esmat1103/can-analyzer-stm32/docs/demo.gif

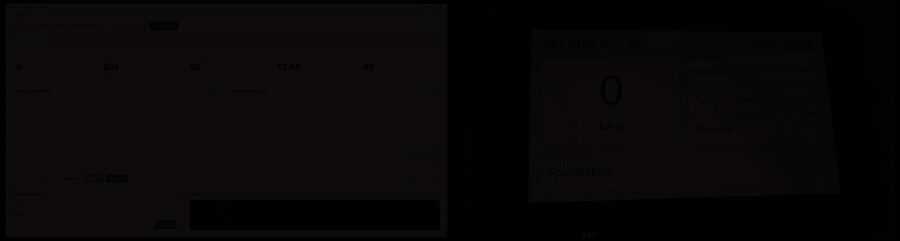
docs/demo.gif
