esmat1103/can-analyzer-stm32/docs/f7_dashboard.jpg

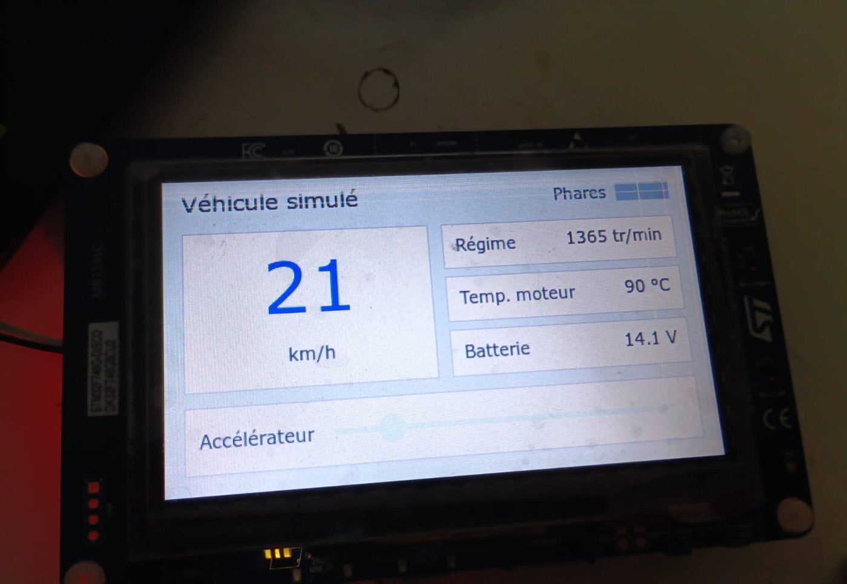
docs/f7_dashboard.jpg
