esmat1103/can-analyzer-stm32/docs/qt_dashboard.png

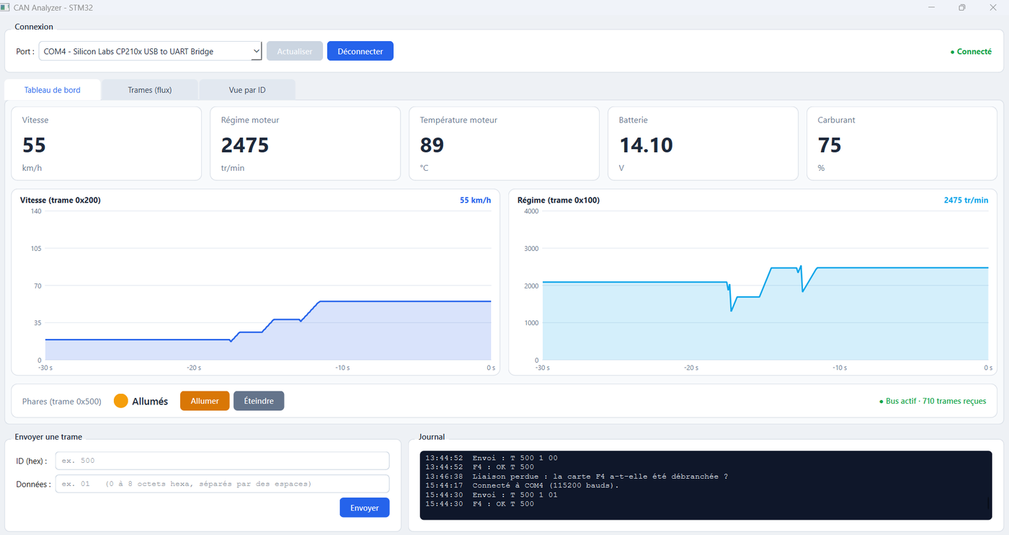
docs/qt_dashboard.png
