esmat1103/can-analyzer-stm32/docs/qt_flux.png

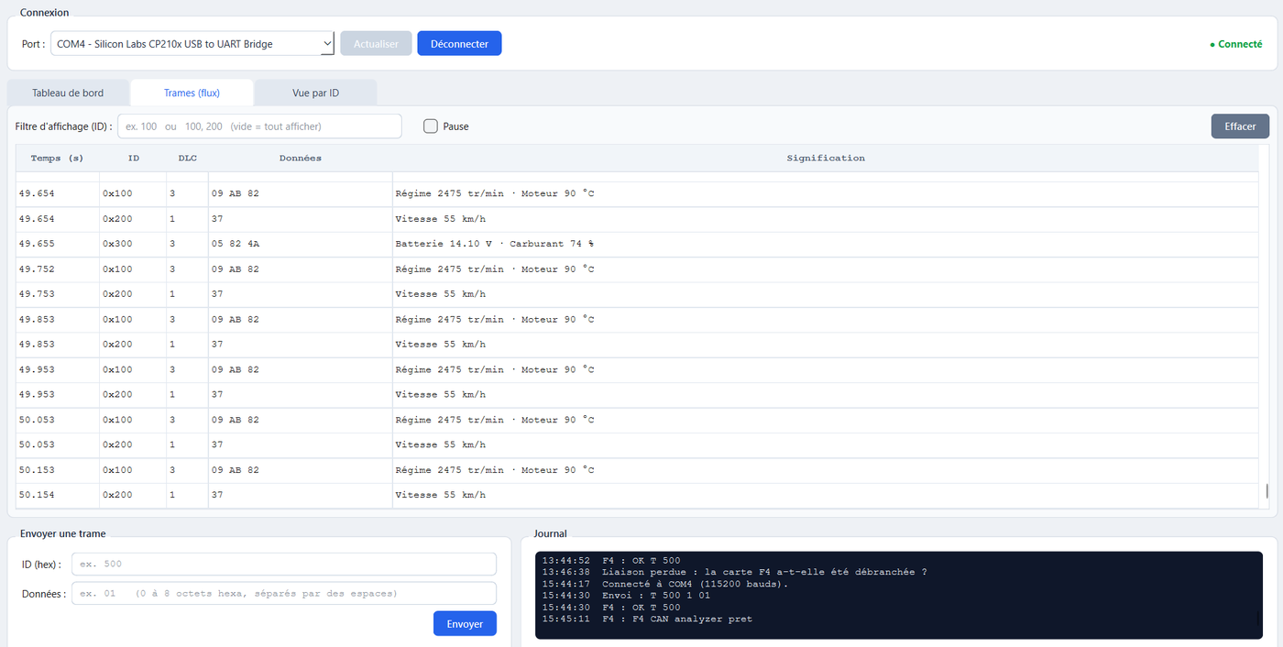
docs/qt_flux.png
