esmat1103/can-analyzer-stm32/docs/qt_par_id.png

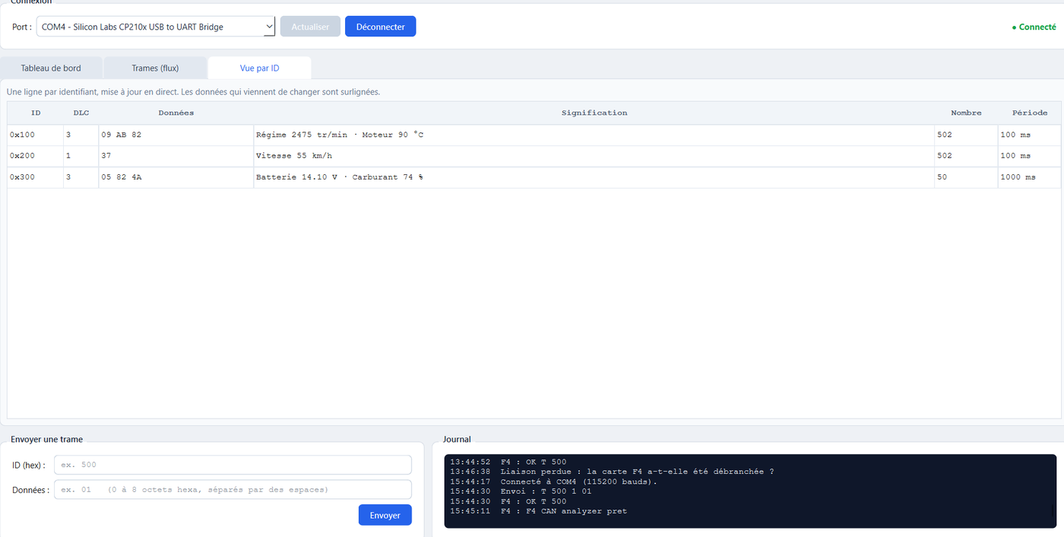
docs/qt_par_id.png
