esmat1103/can-analyzer-stm32/docs/montage.jpg

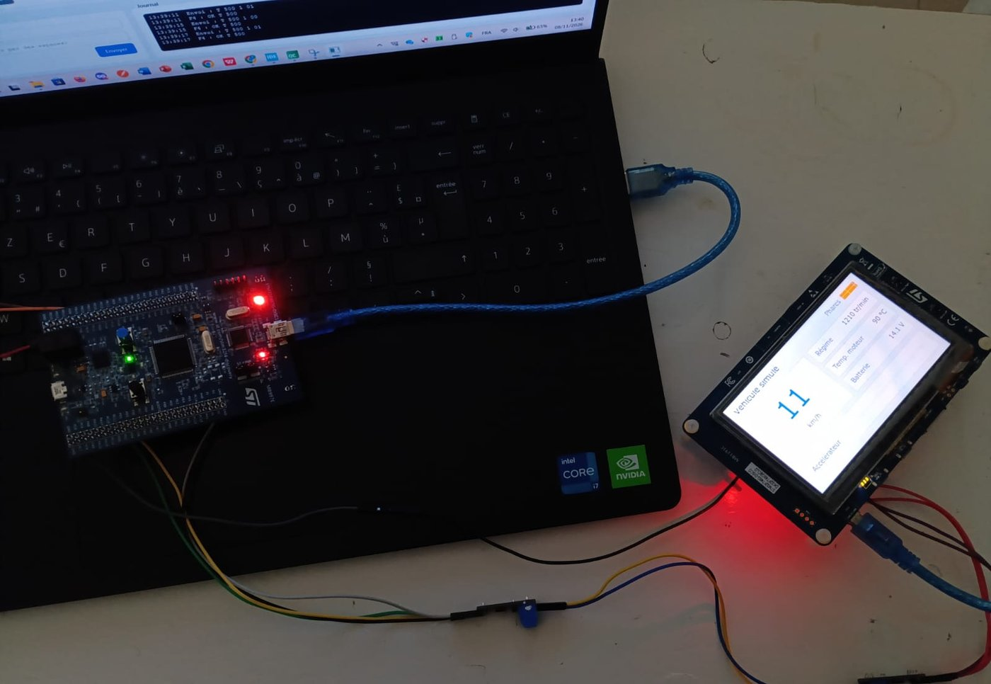
docs/montage.jpg
