esmat1103/can-analyzer-stm32/firmware/F7_vehicle_touchgfx/Core/Src/main.c

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
/* Includes ------------------------------------------------------------------*/
#include "main.h"
#include "cmsis_os.h"
#include "libjpeg.h"
#include "app_touchgfx.h"

/* USER CODE BEGIN Includes */
#include "gui/vehicule.h"
/* USER CODE END Includes */

/* USER CODE BEGIN PD */

#define REFRESH_COUNT        1835

#define SDRAM_TIMEOUT                            ((uint32_t)0xFFFF)
#define SDRAM_MODEREG_BURST_LENGTH_1             ((uint16_t)0x0000)
#define SDRAM_MODEREG_BURST_LENGTH_2             ((uint16_t)0x0001)
#define SDRAM_MODEREG_BURST_LENGTH_4             ((uint16_t)0x0002)
#define SDRAM_MODEREG_BURST_LENGTH_8             ((uint16_t)0x0004)
#define SDRAM_MODEREG_BURST_TYPE_SEQUENTIAL      ((uint16_t)0x0000)
#define SDRAM_MODEREG_BURST_TYPE_INTERLEAVED     ((uint16_t)0x0008)
#define SDRAM_MODEREG_CAS_LATENCY_2              ((uint16_t)0x0020)
#define SDRAM_MODEREG_CAS_LATENCY_3              ((uint16_t)0x0030)
#define SDRAM_MODEREG_OPERATING_MODE_STANDARD    ((uint16_t)0x0000)
#define SDRAM_MODEREG_WRITEBURST_MODE_PROGRAMMED ((uint16_t)0x0000)
#define SDRAM_MODEREG_WRITEBURST_MODE_SINGLE     ((uint16_t)0x0200)

#define FLASH_READ_JEDEC_ID				0x9F
#define FLASH_FAST_READ_QUAD_IO		 	0xEB
#define FLASH_REVC03_MANUFACTURER_ID	0xEF
#define FLASH_N25Q128A_DUMMY_CYCLES		0x0A
#define FLASH_W25Q128J_DUMMY_CYCLES		0x06

/* USER CODE END PD */

CAN_HandleTypeDef hcan1;

CRC_HandleTypeDef hcrc;

DMA2D_HandleTypeDef hdma2d;

I2C_HandleTypeDef hi2c3;

LTDC_HandleTypeDef hltdc;

QSPI_HandleTypeDef hqspi;

SDRAM_HandleTypeDef hsdram1;

/* Definitions for defaultTask */
osThreadId_t defaultTaskHandle;
const osThreadAttr_t defaultTask_attributes = {
  .name = "defaultTask",
  .stack_size = 256 * 4,
  .priority = (osPriority_t) osPriorityNormal,
};
/* Definitions for TouchGFXTask */
osThreadId_t TouchGFXTaskHandle;
const osThreadAttr_t TouchGFXTask_attributes = {
  .name = "TouchGFXTask",
  .stack_size = 4096 * 4,
  .priority = (osPriority_t) osPriorityNormal,
};
/* Definitions for videoTask */
osThreadId_t videoTaskHandle;
const osThreadAttr_t videoTask_attributes = {
  .name = "videoTask",
  .stack_size = 1000 * 4,
  .priority = (osPriority_t) osPriorityLow,
};
/* Definitions for vehiculeTas */
osThreadId_t vehiculeTasHandle;
const osThreadAttr_t vehiculeTas_attributes = {
  .name = "vehiculeTas",
  .stack_size = 256 * 4,
  .priority = (osPriority_t) osPriorityNormal,
};
/* USER CODE BEGIN PV */
static FMC_SDRAM_CommandTypeDef Command;

/* Etat partage du vehicule : ecrit par la tache vehicule et l'interruption CAN, lu par l'ecran */
static volatile EtatVehicule etat = {0, 800, 20, 126, 0};
static volatile int consigneVitesse = 0;   /* valeur du curseur, en km/h */
/* USER CODE END PV */

void SystemClock_Config(void);
static void MPU_Config(void);
static void MX_GPIO_Init(void);
static void MX_CRC_Init(void);
static void MX_DMA2D_Init(void);
static void MX_FMC_Init(void);
static void MX_I2C3_Init(void);
static void MX_LTDC_Init(void);
static void MX_QUADSPI_Init(void);
static void MX_CAN1_Init(void);
void StartDefaultTask(void *argument);
extern void TouchGFX_Task(void *argument);
extern void videoTaskFunc(void *argument);
void StartVehiculeTask(void *argument);

/* USER CODE BEGIN PFP */
void GetManufacturerId (uint8_t *manufacturer_id);
void EnableMemoryMappedMode(uint8_t manufacturer_id);  

/* USER CODE END PFP */

/* USER CODE BEGIN 0 */
/* ---------- Fonctions appelees par l'ecran ---------- */

void Vehicule_SetConsigne(int vitesse_kmh)
{
  if (vitesse_kmh < 0)   vitesse_kmh = 0;
  if (vitesse_kmh > 130) vitesse_kmh = 130;
  consigneVitesse = vitesse_kmh;
}

void Vehicule_LireEtat(EtatVehicule *e)
{
  /* Copie protegee : personne ne peut modifier l'etat pendant la lecture */
  uint32_t primask = __get_PRIMASK();
  __disable_irq();
  e->vitesse     = etat.vitesse;
  e->regime      = etat.regime;
  e->temperature = etat.temperature;
  e->tension_dV  = etat.tension_dV;
  e->phares      = etat.phares;
  __set_PRIMASK(primask);
}

/* ---------- Envoi d'une trame CAN standard ---------- */

static void envoyerTrame(uint32_t id, uint8_t *data, uint8_t dlc)
{
  CAN_TxHeaderTypeDef entete = {0};
  uint32_t boite;

  entete.StdId = id;
  entete.IDE   = CAN_ID_STD;
  entete.RTR   = CAN_RTR_DATA;
  entete.DLC   = dlc;

  /* Si les 3 boites d'envoi sont pleines (personne sur le bus), on saute */
  if (HAL_CAN_GetTxMailboxesFreeLevel(&hcan1) > 0)
  {
    HAL_CAN_AddTxMessage(&hcan1, &entete, data, &boite);
  }
}

/* ---------- Reception : appelee par l'interruption CAN ---------- */

void HAL_CAN_RxFifo0MsgPendingCallback(CAN_HandleTypeDef *hcan)
{
  CAN_RxHeaderTypeDef entete;
  uint8_t data[8];

  while (HAL_CAN_GetRxFifoFillLevel(hcan, CAN_RX_FIFO0) > 0)
  {
    if (HAL_CAN_GetRxMessage(hcan, CAN_RX_FIFO0, &entete, data) != HAL_OK)
      break;

    /* Trame 0x500 = commande des phares (octet 0 : 01 allume, 00 eteint) */
    if (entete.IDE == CAN_ID_STD && entete.StdId == 0x500 && entete.DLC >= 1)
    {
      etat.phares = (data[0] != 0) ? 1 : 0;
    }
  }
}

/* ---------- Simulation du vehicule (tache FreeRTOS, toutes les 100 ms) ---------- */

void Vehicule_Tache(void)
{
  /* Rapport tr/min par km/h pour chaque vitesse de boite (index 1 a 5) */
  static const float rapport[6] = {0.0f, 110.0f, 65.0f, 45.0f, 35.0f, 28.0f};

  float vitesse     = 0.0f;
  float temperature = 20.0f;
  int carburant     = 75;          /* en % */
  uint32_t compteur = 0;
  uint32_t prochain = osKernelGetTickCount();
  uint8_t d[8];

  for (;;)
  {
    prochain += 100;               /* prochaine execution dans 100 ms */

    /* 1. La vitesse rejoint progressivement la consigne du curseur */
    int cible = consigneVitesse;
    if (vitesse < cible)
    {
      vitesse += 1.5f;
      if (vitesse > cible) vitesse = (float)cible;
    }
    else if (vitesse > cible)
    {
      vitesse -= 2.0f;
      if (vitesse < cible) vitesse = (float)cible;
    }
    int v = (int)(vitesse + 0.5f);

    /* 2. Le regime depend de la vitesse et du rapport engage */
    int rapportEngage = (v < 20) ? 1 : (v < 40) ? 2 : (v < 60) ? 3 : (v < 85) ? 4 : 5;
    int regime = (int)(vitesse * rapport[rapportEngage]);
    if (regime < 800) regime = 800;

    /* 3. Le moteur chauffe doucement jusqu'a 90 degres */
    temperature += (90.0f - temperature) * 0.01f;
    int temp = (int)(temperature + 0.5f);

    /* 4. Batterie : 14.1 V quand l'alternateur charge, 12.6 V au ralenti */
    int tension = (regime > 900) ? 141 : 126;

    /* 5. Carburant : -1 % par minute */
    if ((compteur % 600) == 599 && carburant > 5) carburant--;

    /* Mise a jour de l'etat lu par l'ecran */
    etat.vitesse     = v;
    etat.regime      = regime;
    etat.temperature = temp;
    etat.tension_dV  = tension;

    /* Trame 0x100 (moteur, 100 ms) : regime sur 2 octets + temperature + 40 */
    d[0] = (uint8_t)(regime >> 8);
    d[1] = (uint8_t)(regime & 0xFF);
    d[2] = (uint8_t)(temp + 40);
    envoyerTrame(0x100, d, 3);

    /* Trame 0x200 (ABS, 100 ms) : vitesse en km/h */
    d[0] = (uint8_t)v;
    envoyerTrame(0x200, d, 1);

    /* Trame 0x300 (batterie, 1 s) : tension en centiemes de volt + carburant */
    if ((compteur % 10) == 0)
    {
      int centiemes = tension * 10;
      d[0] = (uint8_t)(centiemes >> 8);
      d[1] = (uint8_t)(centiemes & 0xFF);
      d[2] = (uint8_t)carburant;
      envoyerTrame(0x300, d, 3);
    }

    compteur++;
    osDelayUntil(prochain);
  }
}


/* USER CODE END 0 */

/**
  * @brief  The application entry point.
  * @retval int
  */
int main(void)
{

  /* MPU Configuration--------------------------------------------------------*/
  MPU_Config();

  /* Enable the CPU Cache */

  /* Enable I-Cache---------------------------------------------------------*/
  SCB_EnableICache();

  /* Enable D-Cache---------------------------------------------------------*/
  SCB_EnableDCache();

  /* MCU Configuration--------------------------------------------------------*/

  /* Reset of all peripherals, Initializes the Flash interface and the Systick. */
  HAL_Init();

  /* Configure the system clock */
  SystemClock_Config();

  /* Initialize all configured peripherals */
  MX_GPIO_Init();
  MX_CRC_Init();
  MX_DMA2D_Init();
  MX_FMC_Init();
  MX_I2C3_Init();
  MX_LTDC_Init();
  MX_QUADSPI_Init();
  MX_LIBJPEG_Init();
  MX_CAN1_Init();
  MX_TouchGFX_Init();
  /* Call PreOsInit function */
  MX_TouchGFX_PreOSInit();
  /* USER CODE BEGIN 2 */
  /* Filtre CAN : on ne recoit QUE la trame 0x500 (commande des phares) */
    CAN_FilterTypeDef filtre = {0};
    filtre.FilterBank           = 0;
    filtre.FilterMode           = CAN_FILTERMODE_IDMASK;
    filtre.FilterScale          = CAN_FILTERSCALE_32BIT;
    filtre.FilterIdHigh         = 0x500 << 5;
    filtre.FilterIdLow          = 0x0000;
    filtre.FilterMaskIdHigh     = 0x7FF << 5;
    filtre.FilterMaskIdLow      = 0x0000;
    filtre.FilterFIFOAssignment = CAN_RX_FIFO0;
    filtre.FilterActivation     = ENABLE;
    filtre.SlaveStartFilterBank = 14;
    if (HAL_CAN_ConfigFilter(&hcan1, &filtre) != HAL_OK) Error_Handler();

    if (HAL_CAN_ActivateNotification(&hcan1, CAN_IT_RX_FIFO0_MSG_PENDING) != HAL_OK) Error_Handler();
    if (HAL_CAN_Start(&hcan1) != HAL_OK) Error_Handler();
  /* USER CODE END 2 */

  /* Init scheduler */
  osKernelInitialize();

  /* USER CODE BEGIN RTOS_MUTEX */
  /* add mutexes, ... */
  /* USER CODE END RTOS_MUTEX */

  /* USER CODE BEGIN RTOS_SEMAPHORES */
  /* add semaphores, ... */
  /* USER CODE END RTOS_SEMAPHORES */

  /* USER CODE BEGIN RTOS_TIMERS */
  /* start timers, add new ones, ... */
  /* USER CODE END RTOS_TIMERS */

  /* USER CODE BEGIN RTOS_QUEUES */
  /* add queues, ... */
  /* USER CODE END RTOS_QUEUES */

  /* Create the thread(s) */
  /* creation of defaultTask */
  defaultTaskHandle = osThreadNew(StartDefaultTask, NULL, &defaultTask_attributes);

  /* creation of TouchGFXTask */
  TouchGFXTaskHandle = osThreadNew(TouchGFX_Task, NULL, &TouchGFXTask_attributes);

  /* creation of videoTask */
  videoTaskHandle = osThreadNew(videoTaskFunc, NULL, &videoTask_attributes);

  /* creation of vehiculeTas */
  vehiculeTasHandle = osThreadNew(StartVehiculeTask, NULL, &vehiculeTas_attributes);

  /* USER CODE BEGIN RTOS_THREADS */
  /* add threads, ... */
  /* USER CODE END RTOS_THREADS */

  /* USER CODE BEGIN RTOS_EVENTS */
  /* add events, ... */
  /* USER CODE END RTOS_EVENTS */

  /* Start scheduler */
  osKernelStart();

  /* We should never get here as control is now taken by the scheduler */

  /* Infinite loop */
  /* USER CODE BEGIN WHILE */
  while (1)
  {
    /* USER CODE END WHILE */

    /* USER CODE BEGIN 3 */
  }
  /* USER CODE END 3 */
}

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
/* USER CODE BEGIN 4 */

// Read manufacturer ID of external QSPI flash
void GetManufacturerId (uint8_t *manufacturer_id)
{
  QSPI_CommandTypeDef s_command_id;

  /* Initialize the read flag status register command */
  s_command_id.InstructionMode   = QSPI_INSTRUCTION_1_LINE;
  s_command_id.Instruction       = FLASH_READ_JEDEC_ID;
  s_command_id.AddressMode       = QSPI_ADDRESS_NONE;
  s_command_id.AlternateByteMode = QSPI_ALTERNATE_BYTES_NONE;
  s_command_id.DataMode          = QSPI_DATA_1_LINE;
  s_command_id.DummyCycles       = 0;
  s_command_id.NbData            = 1;
  s_command_id.DdrMode           = QSPI_DDR_MODE_DISABLE;
  s_command_id.DdrHoldHalfCycle  = QSPI_DDR_HHC_ANALOG_DELAY;
  s_command_id.SIOOMode          = QSPI_SIOO_INST_EVERY_CMD;

  /* Configure the command */
  if (HAL_QSPI_Command(&hqspi, &s_command_id, HAL_QPSI_TIMEOUT_DEFAULT_VALUE) != HAL_OK)
  {
	  Error_Handler();
  }

  /* Reception of the data */
  if (HAL_QSPI_Receive(&hqspi, manufacturer_id, HAL_QPSI_TIMEOUT_DEFAULT_VALUE) != HAL_OK)
  {
	  Error_Handler();
  }
}

// Enable memory mapped mode for external QSPI flash
void EnableMemoryMappedMode(uint8_t manufacturer_id)  
{
  QSPI_CommandTypeDef      s_command;
  QSPI_MemoryMappedTypeDef s_mem_mapped_cfg;

  /* Configure the command for the read instruction */
  s_command.InstructionMode   = QSPI_INSTRUCTION_1_LINE;
  s_command.Instruction       = FLASH_FAST_READ_QUAD_IO;
  s_command.AddressMode       = QSPI_ADDRESS_4_LINES;
  s_command.AddressSize       = QSPI_ADDRESS_24_BITS;
  s_command.AlternateByteMode = QSPI_ALTERNATE_BYTES_NONE;
  s_command.DataMode          = QSPI_DATA_4_LINES;
  
  // Set dummy cycles according to manufacturer ID
  s_command.DummyCycles       = manufacturer_id == FLASH_REVC03_MANUFACTURER_ID ? FLASH_W25Q128J_DUMMY_CYCLES : FLASH_N25Q128A_DUMMY_CYCLES;

  s_command.DdrMode           = QSPI_DDR_MODE_DISABLE;
  s_command.DdrHoldHalfCycle  = QSPI_DDR_HHC_ANALOG_DELAY;
  s_command.SIOOMode          = QSPI_SIOO_INST_EVERY_CMD;
  
  /* Configure the memory mapped mode */
  s_mem_mapped_cfg.TimeOutActivation = QSPI_TIMEOUT_COUNTER_DISABLE;
  s_mem_mapped_cfg.TimeOutPeriod     = 0;
  
  if (HAL_QSPI_MemoryMapped(&hqspi, &s_command, &s_mem_mapped_cfg) != HAL_OK)
  {
    Error_Handler();
  }
}

/* USER CODE END 4 */

/* USER CODE BEGIN Header_StartDefaultTask */
/**
  * @brief  Function implementing the defaultTask thread.
  * @param  argument: Not used
  * @retval None
  */
/* USER CODE END Header_StartDefaultTask */
void StartDefaultTask(void *argument)
{
  /* USER CODE BEGIN 5 */
  /* Infinite loop */
  for(;;)
  {
    osDelay(100);
  }
  /* USER CODE END 5 */
}

/* USER CODE BEGIN Header_StartVehiculeTask */
/**
* @brief Function implementing the vehiculeTas thread.
* @param argument: Not used
* @retval None
*/
/* USER CODE END Header_StartVehiculeTask */
__weak void StartVehiculeTask(void *argument)
{
  /* USER CODE BEGIN StartVehiculeTask */
  /* Infinite loop */
	  Vehicule_Tache();

  /* USER CODE END StartVehiculeTask */
}

 /* MPU Configuration */

void MPU_Config(void)
{
  MPU_Region_InitTypeDef MPU_InitStruct = {0};

  /* Disables the MPU */
  HAL_MPU_Disable();

  /** Initializes and configures the Region and the memory to be protected
  */
  MPU_InitStruct.Enable = MPU_REGION_ENABLE;
  MPU_InitStruct.Number = MPU_REGION_NUMBER0;
  MPU_InitStruct.BaseAddress = 0x90000000;
  MPU_InitStruct.Size = MPU_REGION_SIZE_256MB;
  MPU_InitStruct.SubRegionDisable = 0x0;
  MPU_InitStruct.TypeExtField = MPU_TEX_LEVEL0;
  MPU_InitStruct.AccessPermission = MPU_REGION_FULL_ACCESS;
  MPU_InitStruct.DisableExec = MPU_INSTRUCTION_ACCESS_ENABLE;
  MPU_InitStruct.IsShareable = MPU_ACCESS_NOT_SHAREABLE;
  MPU_InitStruct.IsCacheable = MPU_ACCESS_NOT_CACHEABLE;
  MPU_InitStruct.IsBufferable = MPU_ACCESS_NOT_BUFFERABLE;

  HAL_MPU_ConfigRegion(&MPU_InitStruct);

  /** Initializes and configures the Region and the memory to be protected
  */
  MPU_InitStruct.Number = MPU_REGION_NUMBER1;
  MPU_InitStruct.Size = MPU_REGION_SIZE_16MB;
  MPU_InitStruct.IsCacheable = MPU_ACCESS_CACHEABLE;

  HAL_MPU_ConfigRegion(&MPU_InitStruct);
  /* Enables the MPU */
  HAL_MPU_Enable(MPU_PRIVILEGED_DEFAULT);

}

/**
  * @brief  Period elapsed callback in non blocking mode
  * @note   This function is called  when TIM6 interrupt took place, inside
  * HAL_TIM_IRQHandler(). It makes a direct call to HAL_IncTick() to increment
  * a global variable "uwTick" used as application time base.
  * @param  htim : TIM handle
  * @retval None
  */
void HAL_TIM_PeriodElapsedCallback(TIM_HandleTypeDef *htim)
{
  if (htim->Instance == TIM6)
  {
    HAL_IncTick();
  }
}

/**
  * @brief  This function is executed in case of error occurrence.
  * @retval None
  */
void Error_Handler(void)
{
  /* USER CODE BEGIN Error_Handler_Debug */
  /* User can add his own implementation to report the HAL error return state */

  /* USER CODE END Error_Handler_Debug */
}
#ifdef USE_FULL_ASSERT
/**
  * @brief  Reports the name of the source file and the source line number
  *         where the assert_param error has occurred.
  * @param  file: pointer to the source file name
  * @param  line: assert_param error line source number
  * @retval None
  */
void assert_failed(uint8_t *file, uint32_t line)
{
  /* USER CODE BEGIN 6 */
  /* User can add his own implementation to report the file name and line number,
     tex: printf("Wrong parameters value: file %s on line %d\r\n", file, line) */
  /* USER CODE END 6 */
}
#endif /* USE_FULL_ASSERT */
