esmat1103/can-analyzer-stm32/firmware/F7_vehicle_touchgfx/MyApplication.ioc

Mcu.UserName=STM32F746NGHx
PA13.Signal=SYS_JTMS-SWDIO
PA14.Signal=SYS_JTCK-SWCLK
PB2.Signal=QUADSPI_CLK
PB4.GPIO_Label=VSYNC_FREQ
PB4.Signal=GPIO_Output
PB6.Signal=QUADSPI_BK1_NCS
PB8.Signal=CAN1_RX
PB9.Signal=CAN1_TX
PC3.Signal=FMC_SDCKE0
PC6.GPIO_Label=RENDER_TIME
PC6.Signal=GPIO_Output
PC7.GPIO_Label=FRAME_RATE
PC7.Signal=GPIO_Output
PD0.Signal=FMC_D2_DA2
PD1.Signal=FMC_D3_DA3
PD10.Signal=FMC_D15_DA15
PD11.Signal=QUADSPI_BK1_IO0
PD12.Signal=QUADSPI_BK1_IO1
PD13.Signal=QUADSPI_BK1_IO3
PD14.Signal=FMC_D0_DA0
PD15.Signal=FMC_D1_DA1
PD8.Signal=FMC_D13_DA13
PD9.Signal=FMC_D14_DA14
PE0.Signal=FMC_NBL0
PE1.Signal=FMC_NBL1
PE10.Signal=FMC_D7_DA7
PE11.Signal=FMC_D8_DA8
PE12.Signal=FMC_D9_DA9
PE13.Signal=FMC_D10_DA10
PE14.Signal=FMC_D11_DA11
PE15.Signal=FMC_D12_DA12
PE2.Signal=QUADSPI_BK1_IO2
PE4.Signal=LTDC_B0
PE7.Signal=FMC_D4_DA4
PE8.Signal=FMC_D5_DA5
PE9.Signal=FMC_D6_DA6
PF0.Signal=FMC_A0
PF1.Signal=FMC_A1
PF11.Signal=FMC_SDNRAS
PF12.Signal=FMC_A6
PF13.Signal=FMC_A7
PF14.Signal=FMC_A8
PF15.Signal=FMC_A9
PF2.Signal=FMC_A2
PF3.Signal=FMC_A3
PF4.Signal=FMC_A4
PF5.Signal=FMC_A5
PG0.Signal=FMC_A10
PG1.Signal=FMC_A11
PG12.Signal=LTDC_B4
PG15.Signal=FMC_SDNCAS
PG4.Signal=FMC_A14_BA0
PG5.Signal=FMC_A15_BA1
PG6.GPIO_Label=MCU_ACTIVE
PG6.Signal=GPIO_Output
PG8.Signal=FMC_SDCLK
PH0/OSC_IN.Signal=RCC_OSC_IN
PH1/OSC_OUT.Signal=RCC_OSC_OUT
PH3.Signal=FMC_SDNE0
PH5.Signal=FMC_SDNWE
PH7.Signal=I2C3_SCL
PH8.Signal=I2C3_SDA
PI10.Signal=LTDC_HSYNC
PI12.GPIO_Label=LCD_DISP
PI12.Signal=GPIO_Output
PI14.Signal=LTDC_CLK
PI15.Signal=LTDC_R0
PI9.Signal=LTDC_VSYNC
PJ0.Signal=LTDC_R1
PJ1.Signal=LTDC_R2
PJ10.Signal=LTDC_G3
PJ11.Signal=LTDC_G4
PJ13.Signal=LTDC_B1
PJ14.Signal=LTDC_B2
PJ15.Signal=LTDC_B3
PJ2.Signal=LTDC_R3
PJ3.Signal=LTDC_R4
PJ4.Signal=LTDC_R5
PJ5.Signal=LTDC_R6
PJ6.Signal=LTDC_R7
PJ7.Signal=LTDC_G0
PJ8.Signal=LTDC_G1
PJ9.Signal=LTDC_G2
PK0.Signal=LTDC_G5
PK1.Signal=LTDC_G6
PK2.Signal=LTDC_G7
PK3.GPIO_Label=LCD_BL_CTRL
PK3.Signal=GPIO_Output
PK4.Signal=LTDC_B5
PK5.Signal=LTDC_B6
PK6.Signal=LTDC_B7
PK7.Signal=LTDC_DE
