esmat1103/can-analyzer-stm32/firmware/F4_can_gateway/Core/Src/main.c

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
/* Includes ------------------------------------------------------------------*/
#include "main.h"

/* USER CODE BEGIN Includes */
#include <stdio.h>
#include <string.h>
#include <stdlib.h>
/* USER CODE END Includes */

/* USER CODE BEGIN PTD */
typedef struct {
    uint32_t id;
    uint8_t dlc;
    uint8_t data[8];
} TrameCAN;
/* USER CODE END PTD */

/* USER CODE BEGIN PD */
#define TAILLE_FILE 32
#define TAILLE_LIGNE 64
/* USER CODE END PD */

CAN_HandleTypeDef hcan1;

UART_HandleTypeDef huart2;

/* USER CODE BEGIN PV */
volatile TrameCAN file[TAILLE_FILE];
volatile uint8_t tete = 0;
volatile uint8_t queue = 0;
volatile uint32_t trames_perdues = 0;

uint8_t octet_recu;
char ligne_pc[TAILLE_LIGNE];
volatile uint8_t pos_ligne = 0;
volatile uint8_t ligne_prete = 0;

/* USER CODE END PV */

void SystemClock_Config(void);
static void MX_GPIO_Init(void);
static void MX_CAN1_Init(void);
static void MX_USART2_UART_Init(void);
/* USER CODE BEGIN PFP */
static void traiter_commande(char *cmd);
/* USER CODE END PFP */

/* USER CODE BEGIN 0 */
void HAL_CAN_RxFifo0MsgPendingCallback(CAN_HandleTypeDef *hcan)
{
    CAN_RxHeaderTypeDef rxHeader;
    uint8_t data[8];

    while (HAL_CAN_GetRxFifoFillLevel(hcan, CAN_RX_FIFO0) > 0)
    {
        if (HAL_CAN_GetRxMessage(hcan, CAN_RX_FIFO0, &rxHeader, data) != HAL_OK)
            break;

        uint8_t suivant = (tete + 1) % TAILLE_FILE;
        if (suivant == queue) {
            trames_perdues++;
            continue;
        }

        file[tete].id = rxHeader.StdId;
        file[tete].dlc = rxHeader.DLC;
        for (int i = 0; i < 8; i++) file[tete].data[i] = data[i];
        tete = suivant;
    }
}

void HAL_UART_RxCpltCallback(UART_HandleTypeDef *huart)
{
    if (huart->Instance == USART2)
    {
        if (!ligne_prete)
        {
            if (octet_recu == '\r' || octet_recu == '\n') {
                if (pos_ligne > 0) {
                    ligne_pc[pos_ligne] = '\0';
                    ligne_prete = 1;
                    pos_ligne = 0;
                }
            } else if (pos_ligne < TAILLE_LIGNE - 1) {
                ligne_pc[pos_ligne++] = octet_recu;
            }
        }
        HAL_UART_Receive_IT(&huart2, &octet_recu, 1);
    }
}

void HAL_UART_ErrorCallback(UART_HandleTypeDef *huart)
{
    if (huart->Instance == USART2) {
        HAL_UART_Receive_IT(&huart2, &octet_recu, 1);
    }
}
/* USER CODE END 0 */

/**
  * @brief  The application entry point.
  * @retval int
  */
int main(void)
{

  /* MCU Configuration--------------------------------------------------------*/

  /* Reset of all peripherals, Initializes the Flash interface and the Systick. */
  HAL_Init();

  /* Configure the system clock */
  SystemClock_Config();

  /* Initialize all configured peripherals */
  MX_GPIO_Init();
  MX_CAN1_Init();
  MX_USART2_UART_Init();
  /* USER CODE BEGIN 2 */

  CAN_FilterTypeDef filtre = {0};
  filtre.FilterBank = 0;
  filtre.FilterMode = CAN_FILTERMODE_IDMASK;
  filtre.FilterScale = CAN_FILTERSCALE_32BIT;
  filtre.FilterFIFOAssignment = CAN_RX_FIFO0;
  filtre.FilterActivation = ENABLE;
  filtre.SlaveStartFilterBank = 14;
  if (HAL_CAN_ConfigFilter(&hcan1, &filtre) != HAL_OK) Error_Handler();

  if (HAL_CAN_ActivateNotification(&hcan1, CAN_IT_RX_FIFO0_MSG_PENDING) != HAL_OK) Error_Handler();
  if (HAL_CAN_Start(&hcan1) != HAL_OK) Error_Handler();

  char debut[] = "# F4 CAN analyzer pret\r\n";
  HAL_UART_Transmit(&huart2, (uint8_t*)debut, strlen(debut), 100);

  HAL_UART_Receive_IT(&huart2, &octet_recu, 1);
  /* USER CODE END 2 */

  /* Infinite loop */
  /* USER CODE BEGIN WHILE */
  while (1)
  {
    /* USER CODE END WHILE */

    /* USER CODE BEGIN 3 */
	    while (queue != tete)
	    {
	        TrameCAN t;
	        t.id = file[queue].id;
	        t.dlc = file[queue].dlc;
	        for (int i = 0; i < 8; i++) t.data[i] = file[queue].data[i];
	        queue = (queue + 1) % TAILLE_FILE;

	        char ligne[48];
	        int n = sprintf(ligne, "R %03lX %d", t.id, t.dlc);
	        for (int i = 0; i < t.dlc; i++) {
	            n += sprintf(ligne + n, " %02X", t.data[i]);
	        }
	        n += sprintf(ligne + n, "\r\n");

	        HAL_UART_Transmit(&huart2, (uint8_t*)ligne, n, 100);
	        HAL_GPIO_TogglePin(GPIOD, GPIO_PIN_12);
	    }
	    if (ligne_prete)
	    {
	        char commande[TAILLE_LIGNE];
	        strcpy(commande, ligne_pc);
	        ligne_prete = 0;
	        traiter_commande(commande);
	    }
	  }
  /* USER CODE END 3 */
}

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
/* USER CODE BEGIN 4 */
static void traiter_commande(char *cmd)
{
    char rep[64];

    if (cmd[0] == 'T' && cmd[1] == ' ')
    {
        char *p = cmd + 2;
        char *fin;

        uint32_t id = strtoul(p, &fin, 16);
        if (fin == p || id > 0x7FF) {
            strcpy(rep, "# ERR identifiant\r\n");
            HAL_UART_Transmit(&huart2, (uint8_t*)rep, strlen(rep), 100);
            return;
        }
        p = fin;

        uint32_t dlc = strtoul(p, &fin, 10);
        if (fin == p || dlc > 8) {
            strcpy(rep, "# ERR longueur\r\n");
            HAL_UART_Transmit(&huart2, (uint8_t*)rep, strlen(rep), 100);
            return;
        }
        p = fin;

        uint8_t data[8] = {0};
        for (uint32_t i = 0; i < dlc; i++) {
            uint32_t v = strtoul(p, &fin, 16);
            if (fin == p || v > 0xFF) {
                strcpy(rep, "# ERR donnees\r\n");
                HAL_UART_Transmit(&huart2, (uint8_t*)rep, strlen(rep), 100);
                return;
            }
            data[i] = (uint8_t)v;
            p = fin;
        }

        CAN_TxHeaderTypeDef txHeader = {0};
        uint32_t txMailbox;
        txHeader.StdId = id;
        txHeader.IDE = CAN_ID_STD;
        txHeader.RTR = CAN_RTR_DATA;
        txHeader.DLC = dlc;

        if (HAL_CAN_AddTxMessage(&hcan1, &txHeader, data, &txMailbox) == HAL_OK) {
            sprintf(rep, "# OK T %03lX\r\n", id);
        } else {
            strcpy(rep, "# ERR bus occupe\r\n");
        }
    }
    else
    {
        strcpy(rep, "# ERR commande inconnue\r\n");
    }

    HAL_UART_Transmit(&huart2, (uint8_t*)rep, strlen(rep), 100);
}
/* USER CODE END 4 */
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
