esmat1103/can-analyzer-stm32/(commit log)

2026-11-08 Ajout du schema de cablage
2026-11-08 Ajout des captures et des photos
2026-11-08 Ajout de la demo animee
