esmat1103/can-analyzer-stm32/(notices)

Notices in the files:
firmware/F4_can_gateway/Core/Src/main.c:
Copyright (c) 2026 STMicroelectronics.
All rights reserved.
This software is licensed under terms that can be found in the LICENSE file
firmware/F7_vehicle_touchgfx/Core/Src/main.c:
© Copyright (c) 2020 STMicroelectronics.
This software component is licensed by ST under Ultimate Liberty license
